agysft/AVR128DB32/schematics/AVRT_2.pdf

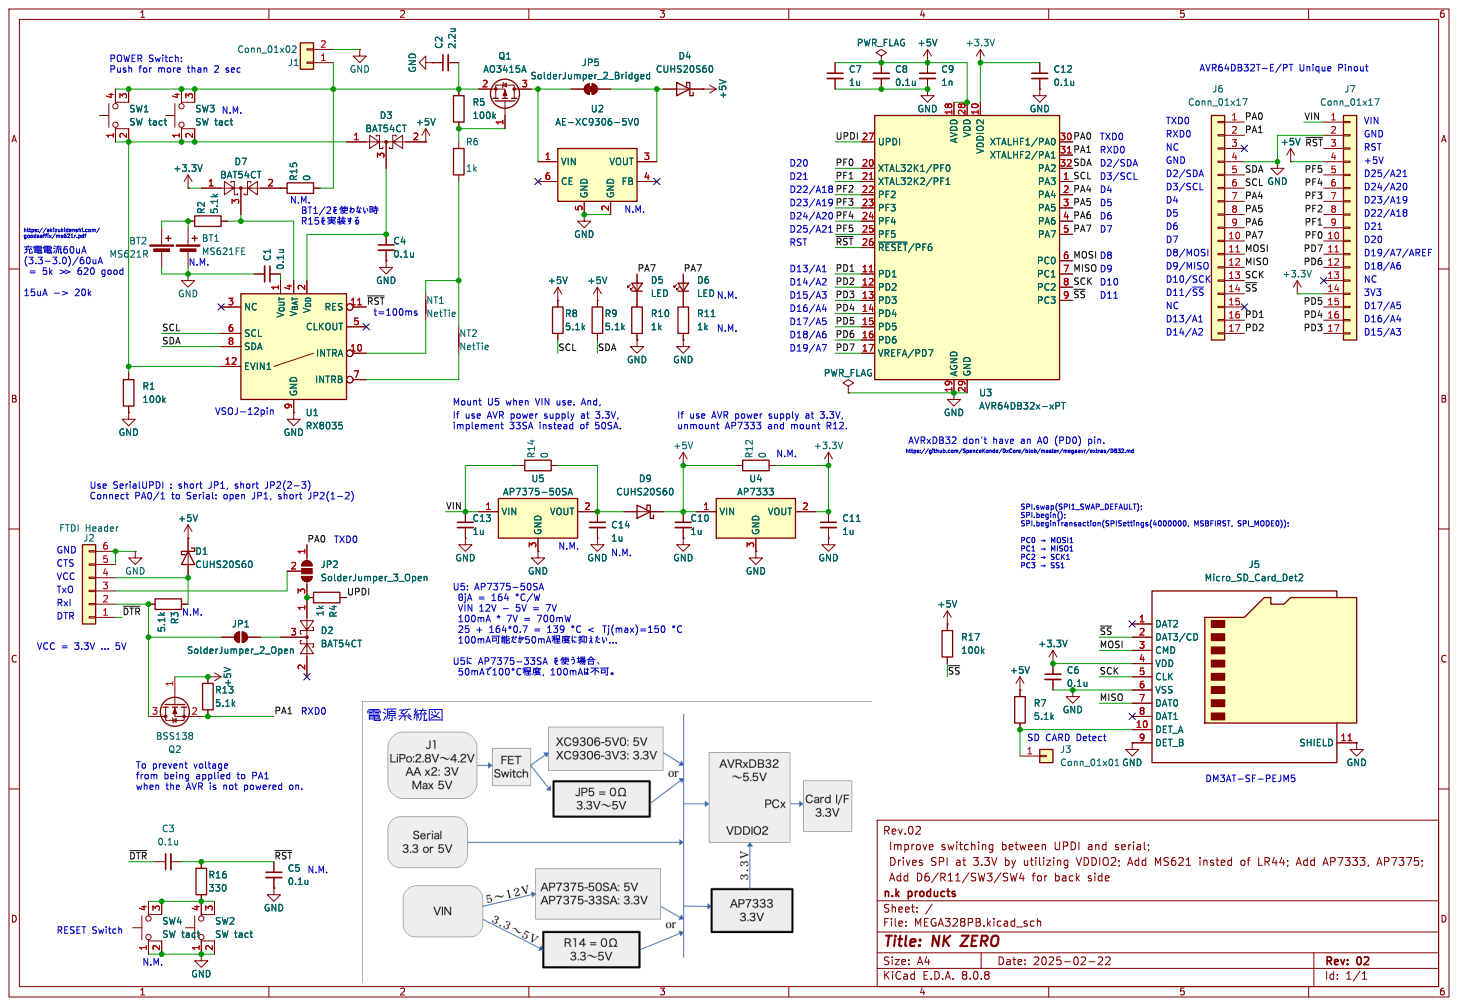
[picture p16: page 1]

https://akizukidenshi.com/ goodsaffix/ms621r.pdf þÿQE–û–ûmA60uA

If use AVR power supply at 3.3V,

3 SW4 SW tact VIN 1 VOUT 2 GND

from being applied to PA1 when the AVR is not powered on.

Id: 1/1 Title: NK ZERO
