agysft/AVR128DB32/(commit log)

2025-08-17 Add contents for AVR board
2025-08-17 Add Arduino settings
2025-08-23 Add 7 images p01-p03, t01-t04; Add zero power consumption in the README.
2025-08-23 Add a power supply diagram.
2025-08-23 Move the board manager description to the features section; Minor changes to the text
